SENA-Centro-Agroturistico/sensores-transmisores/README.md

# sensores-transmisores
Desarrollo de hardware y firmware de sensores transmisores LoRa
