SENA-Centro-Agroturistico/sensores-transmisores/Archivos de diseño/bot.PNG

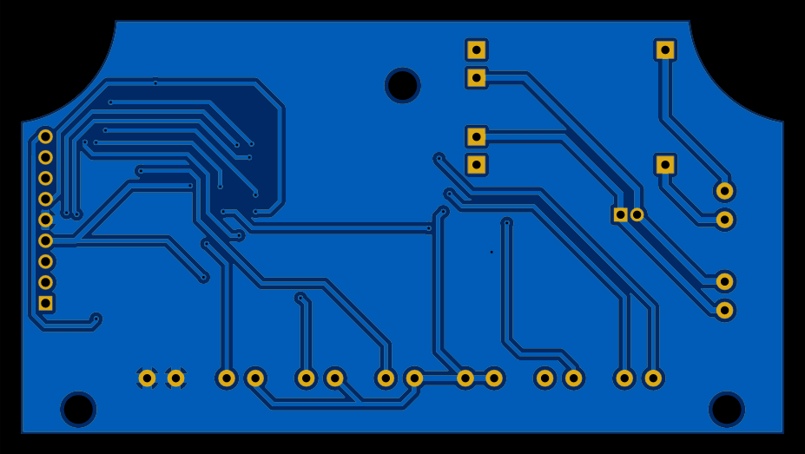
Archivos de diseño/bot.PNG
