SENA-Centro-Agroturistico/sensores-transmisores/Archivos de diseño/top.PNG

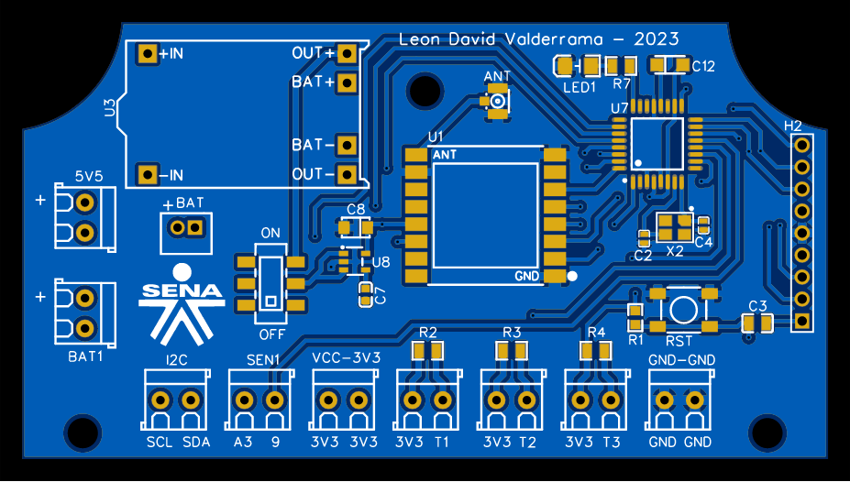
Archivos de diseño/top.PNG
