SENA-Centro-Agroturistico/sensores-transmisores/Archivos de fabricación/Fabricación Gateway LoRa - Wifi/BOM_PCB_SENA 2023 Gateway_2023-12-10.csv

ID | Name | Designator | Footprint | Quantity | Manufacturer Part | Manufacturer | Supplier | Supplier Part | Price
1 | daimob_jumper_smd x2 | JP5,JP6,JP7,JP8 | DAIMOB_JUMPER_2P | 4
2 | SX1276S8S+T-X1 | U5 | WIRELM-SMD_SX1278S165SY-T-X1 | 1 | SX1276S8S+T-X1 | Vollgo | LCSC | C718834 | 5.22
3 | LED-TH-3mm_R | LED | LED-TH_BD3.0_RED | 1 | 204-10SDRD/S530-A3-L | EVERLIGHT(台湾亿光) | LCSC | C84774 | 0.031
4 | 1k | R5 | R_AXIAL-0.4 | 1
5 | DAIMOB_RTC_DS3231_V2 | RTC | RTC-DS3231 | 1
6 | XY301V-A-5.0-2P | I2C,IN-5V5,BAT | CONN-TH_XY301V-A-5.0-2P | 3 | XY301V-A-5.0-2P | XINLAIYA(新莱亚) | LCSC | C557651 | 0.087
7 | XY301V-A-5.0-3P | REL1,REL2 | CONN-TH_XY301V-A-5.0-3P | 2 | XY301V-A-5.0-3P | XINLAIYA(新莱亚) | LCSC | C557652 | 0.134
8 | 1909763-1 | ANT | ANT-SMD_1909763-1 | 1 | 1909763-1 | TE Connectivity | LCSC | C392444 | 0.218
9 | ESP32 DEVKIT 30PIN | U1 | DOIT-ESP32-DEVKIT-V1 | 1 | ESP32 DEVKIT 30PIN |  | Ali Express
10 | 1uF | C1 | CAP-D3.0×F1.5 | 1
11 | 10uF | C3 | CAP-D5.0×F2.0 | 1
12 | HDR-M-2.54_1x1 | J1,J2 | HDR-M-2.54_1X1 | 2 |  |  | LCSC | C81276 | 0.007
13 | daimob-TP4056-modulo | U3 | DAIMOB-TP4056-MODULE-F | 1
14 | AZ1117EH-3.3TRG1 | U4 | SOT-223_L6.5-W3.5-P2.30-LS7.0-BR | 1 | AZ1117EH-3.3TRG1 | DIODES(美台) | LCSC | C108494 | 0.055
15 | SRD-12VDC-SL-C | RELAY1,RELAY2 | RELAY-TH_SRD-XXVDC-XL-C | 2 | SRD-12VDC-SL-C | 松乐 | LCSC | C30431 | 0.318
16 | CYPC817 | U2,U9 | DIP-4_L6.4-W4.6-P2.54-LS7.6-BL | 2 | CYPC817B | OCIC(卓睿科) | LCSC | C385061 | 0.037
17 | 1N4007 | D1,D2 | DO-41_BD2.4-L4.7-P8.70-D0.9-RD | 2 | 1N4007 | ST(先科) | LCSC | C106903 | 0.014
18 | 2N3904 | Q1,Q2 | TO-92-3_L5.1-W4.1-P1.27-L | 2 | 2N3904 | ST(先科) | LCSC | C118538 | 0.016
19 | 120 | R1,R4 | R_AXIAL-0.4 | 2
20 | 470 | R2,R3 | R_AXIAL-0.4 | 2
21 | BAT2 | P1 | CONN-TH_2P-P2.00_PH-2A_C2319 | 1 | PH-2A | BOOMELE(博穆精密) | LCSC | C2319 | 0.005
