SENA-Centro-Agroturistico/sensores-transmisores/Archivos de fabricación/Fabricación Sensor LoRa estándar/BOM_PCB_SENA 2023_2023-12-10.csv

ID | Name | Designator | Footprint | Quantity | Manufacturer Part | Manufacturer | Supplier | Supplier Part | Price
1 | HDR-M-2.54_1x1 | ANT2,J1,J2 | HDR-M-2.54_1X1 | 3 |  |  | LCSC | C81276 | 0.007
2 | 1uF | C1 | CAP-D3.0×F1.5 | 1
3 | 10uF | C3 | CAP-D5.0×F2.0 | 1
4 | 1909763-1 | ANT | ANT-SMD_1909763-1 | 1 | 1909763-1 | TE Connectivity | LCSC | C392444 | 0.218
5 | LED-TH-3mm_R | LED | LED-TH_BD3.0_RED | 1 | 204-10SDRD/S530-A3-L | EVERLIGHT(台湾亿光) | LCSC | C84774 | 0.031
6 | AZ1117EH-3.3TRG1 | U4 | SOT-223_L6.5-W3.5-P2.30-LS7.0-BR | 1 | AZ1117EH-3.3TRG1 | DIODES(美台) | LCSC | C108494 | 0.055
7 | 4.7k | R2,R3,R1 | R_AXIAL-0.4 | 3
8 | 1k | R4 | R_AXIAL-0.4 | 1
9 | KF350-3.5-2P | GND-GND,I2C,SEN1,T1,T2,T3,VCC-3V3,5V5,BAT1 | CONN-TH_P3.50_KF350-3.5-2P | 9 | KF350-3.5-2P | Cixi Kefa Elec | LCSC | C474892 | 0.099
10 | daimob-TP4056-modulo | U3 | DAIMOB-TP4056-MODULE-F | 1
11 | SX1276S8S+T-X1 | U1 | WIRELM-SMD_SX1278S165SY-T-X1 | 1 | SX1276S8S+T-X1 | Vollgo | LCSC | C718834 | 5.22
12 | ARDUINO_PRO_MINI | U2 | ARDUINOPROMINI_ARDUINO_PRO_MINI | 1
13 | BAT2 | P1 | CONN-TH_2P-P2.00_PH-2A_C2319 | 1 | PH-2A | BOOMELE(博穆精密) | LCSC | C2319 | 0.005
