SENA-Centro-Agroturistico/sensores-transmisores/Esquema de circuito/Sensor Estándar - LoRa/Schematic_SENA 2023_modulo_mini_pro_2023-12-10.pdf

## M DULO LORA RFM95W

# A4/SDA GND A6

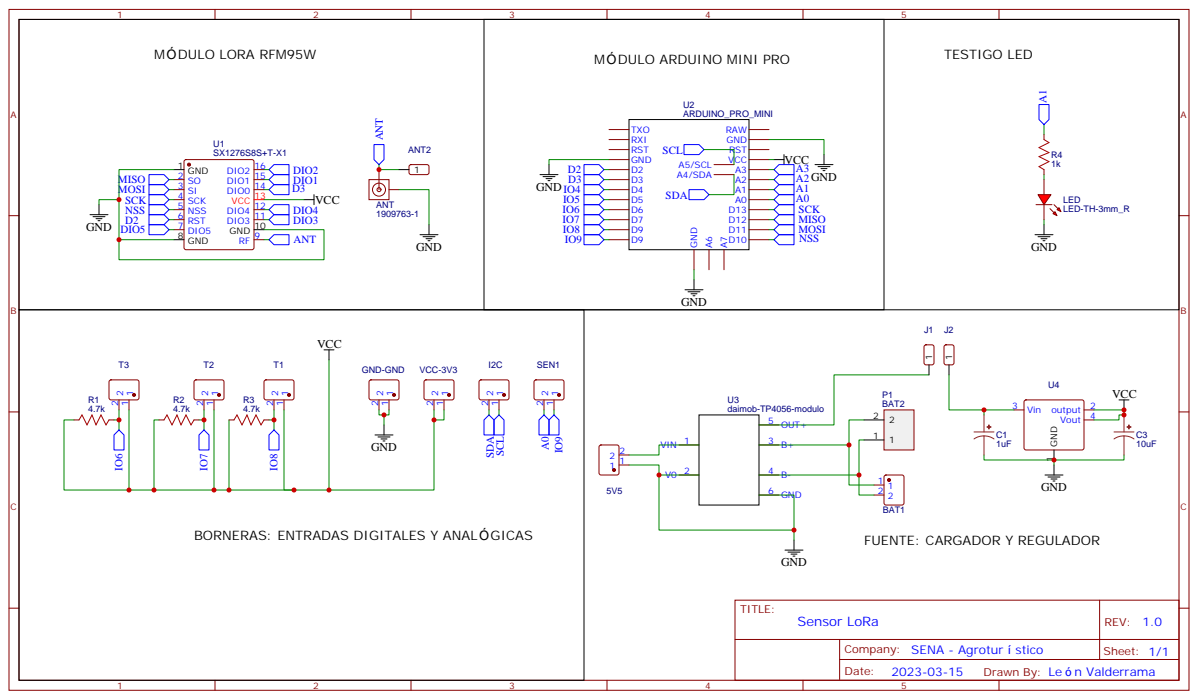
[picture p3: page 1]

FUENTE: CARGADOR Y REGULADOR BORNERAS: ENTRADAS DIGITALES Y ANAL GICAS

Company: SENA - Agrotur stico

Drawn By: Le n Valderrama
