SENA-Centro-Agroturistico/sensores-transmisores/Esquema de circuito/Gateway LoRa - Wifi/Schematic_SENA 2023 Gateway_2023-12-10.pdf

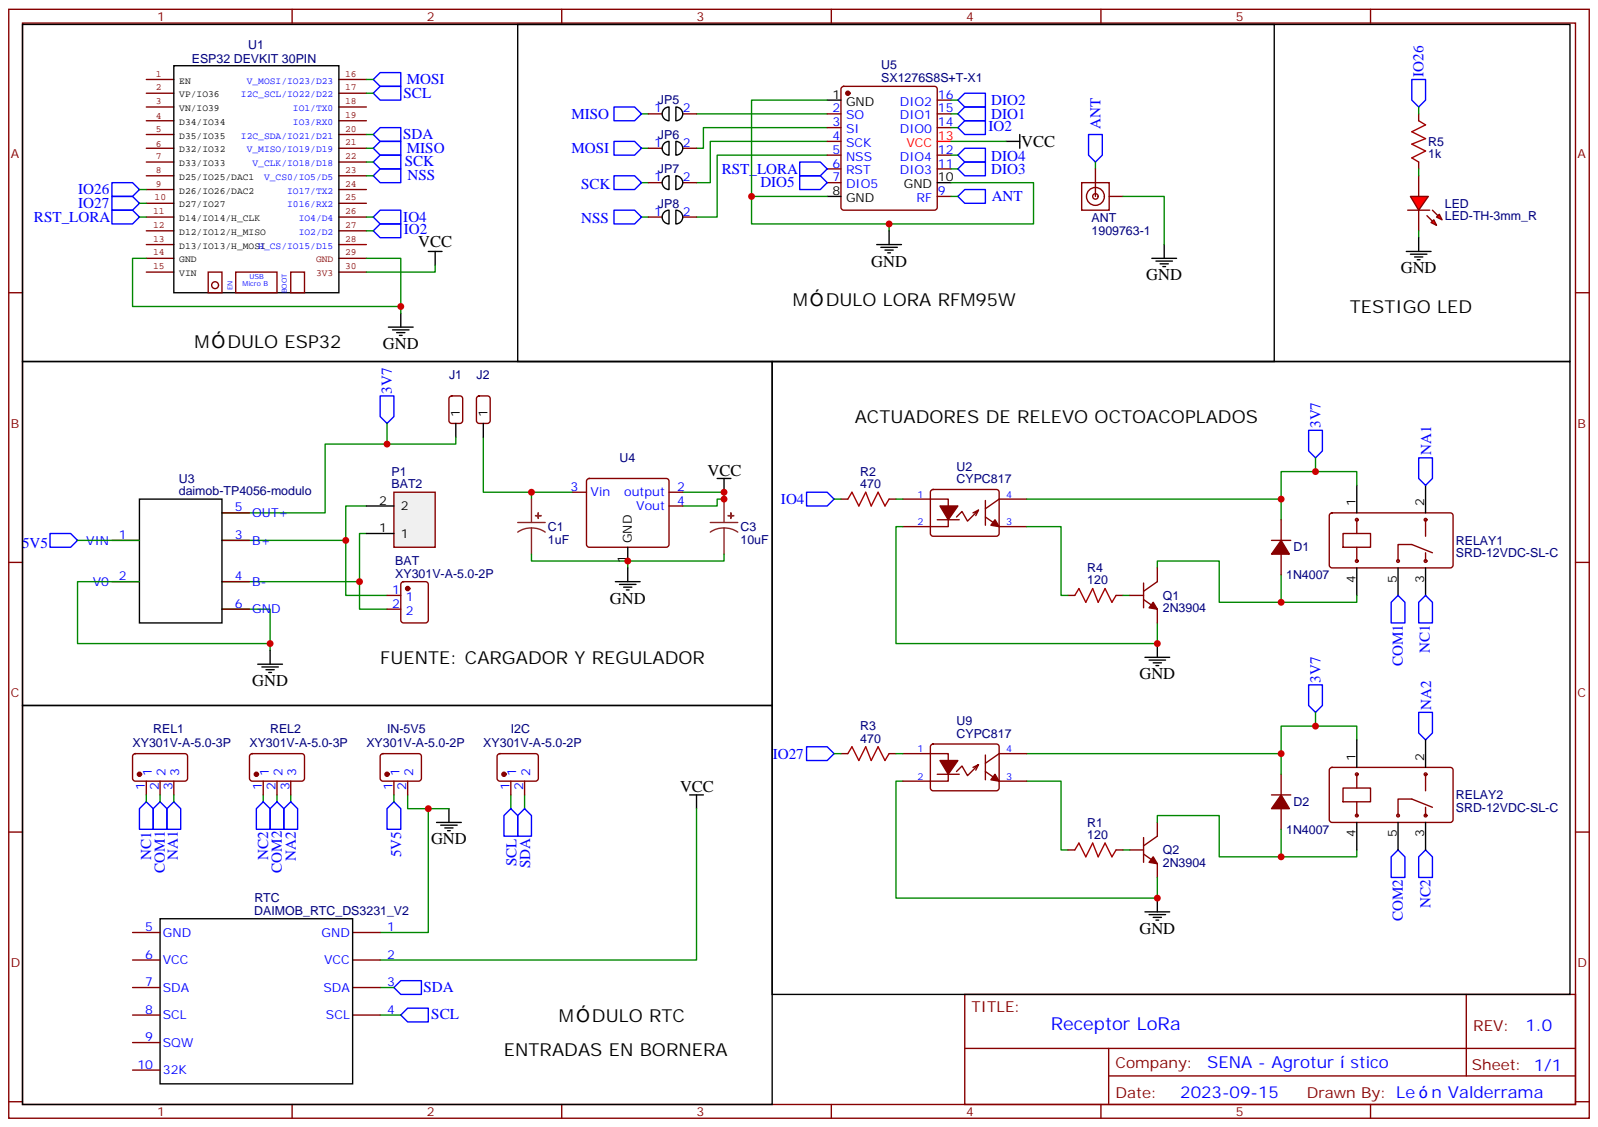
[picture p4: page 1]

ACTUADORES DE RELEVO OCTOACOPLADOS

Company: SENA - Agrotur stico

Drawn By: Le n Valderrama
