SENA-Centro-Agroturistico/sensores-transmisores/(list of files, drawings)

Other design files:
Archivos de diseño/PCB_sensor_lora.json
Esquema de circuito/Gateway LoRa - Wifi/PCB_SENA 2023 Gateway.json
Esquema de circuito/Sensor Estándar - LoRa/PCB_SENA 2023.json
