SENA-Centro-Agroturistico/sensores-transmisores/Firmware/termometro_3_sondas/termometro_3_sondas/mediciones.ino

float tomar_medida(byte sonda) {
  float medida;
  if (sonda == 1) {
    errorMedidaSonda1 = false;
    //Serial.println(F("Midiendo sonda 1: "));
    sensor_1.requestTemperatures();
    medida = sensor_1.getTempC(dir_sensor1);
    if ((medida == 0.00) || isnan(medida) || medida < -40 || medida == 85.00 || medida > 100 || medida == 25.00) {
      Serial.print(F("Error midiendo sonda: ")); Serial.println(sonda);
      errorMedidaSonda1 = true;
      return 999.9;
    }
  }
  else if (sonda == 2) {
    errorMedidaSonda2 = false;
    //Serial.println(F("Midiendo sonda 2: "));
    sensor_2.requestTemperatures();
    medida = sensor_2.getTempC(dir_sensor2);
    if ((medida == 0.00) || isnan(medida) || medida < -40 || medida == 85.00 || medida > 100 || medida == 25.00) {
      Serial.print(F("Error midiendo sonda: ")); Serial.println(sonda);
      errorMedidaSonda2 = true;
      return 999.9;
    }
  }
  else if (sonda == 3) {
    errorMedidaSonda3 = false;
    //Serial.println(F("Midiendo sonda 3: "));
    sensor_3.requestTemperatures();
    medida = sensor_3.getTempC(dir_sensor3);
    if ((medida == 0.00) || isnan(medida) || medida < -40 || medida == 85.00 || medida > 100 || medida == 25.00) {
      Serial.print(F("Error midiendo sonda: ")); Serial.println(sonda);
      errorMedidaSonda3 = true;
      return 999.99;
    }
  }

  Serial.print(medida); Serial.println(F(" C"));
  return medida;
}

//-- Medicion de la bateria
byte medir_bateria() {
  ADMUX = _BV(REFS0) | _BV(MUX3) | _BV(MUX2) | _BV(MUX1);
  delay(2);
  ADCSRA |= _BV(ADSC);
  while (bit_is_set(ADCSRA, ADSC));
  uint8_t low = ADCL;
  uint8_t high = ADCH;
  long result = (high << 8) | low;
  result = 1125300L / result; // Calcula Vcc (en mV); 1125300 = 1.1*1023*1000
  //Serial.print(F("vBat: ")); Serial.print(result);
  if (result < B_MIN) result = B_MIN;
  if (result > B_MAX) result = B_MAX;
  byte bateria = map(result, B_MIN, B_MAX, 0, 100);
  //Serial.print(F(" - bateria: ")); Serial.println(bateria);
  return bateria; // Vcc en porcentaje 0 - 100% 3000 - 3300
}
