SENA-Centro-Agroturistico/sensores-transmisores/(commit log)

2023-04-14 Esquemas de cirucito transmisor
2023-04-14 Archivos de diseño
    Archivo esquemático EasyEDA, imagen de circuito por cada cara
    [PCB_SENA 2023.json]
2023-04-16 Nuevo puerto GND doble para sensor I2C
    [PCB_SENA 2023.json, PCB_sensor_lora.json]
2023-12-11 Versiones estables - Entrega Dic 2023
    [BOM_PCB_SENA 2023 Gateway_2023-12-10.csv, BOM_PCB_SENA 2023_2023-12-10.csv, PCB_SENA 2023 Gateway.json, PCB_SENA 2023.json, PickAndPlace_PCB_SENA 2023 Gateway_2023-12-10.csv, PickAndPlace_PCB_SENA 2023_2023-12-10.csv]
